thilinasGit/ESP01S_Light/3D view.png

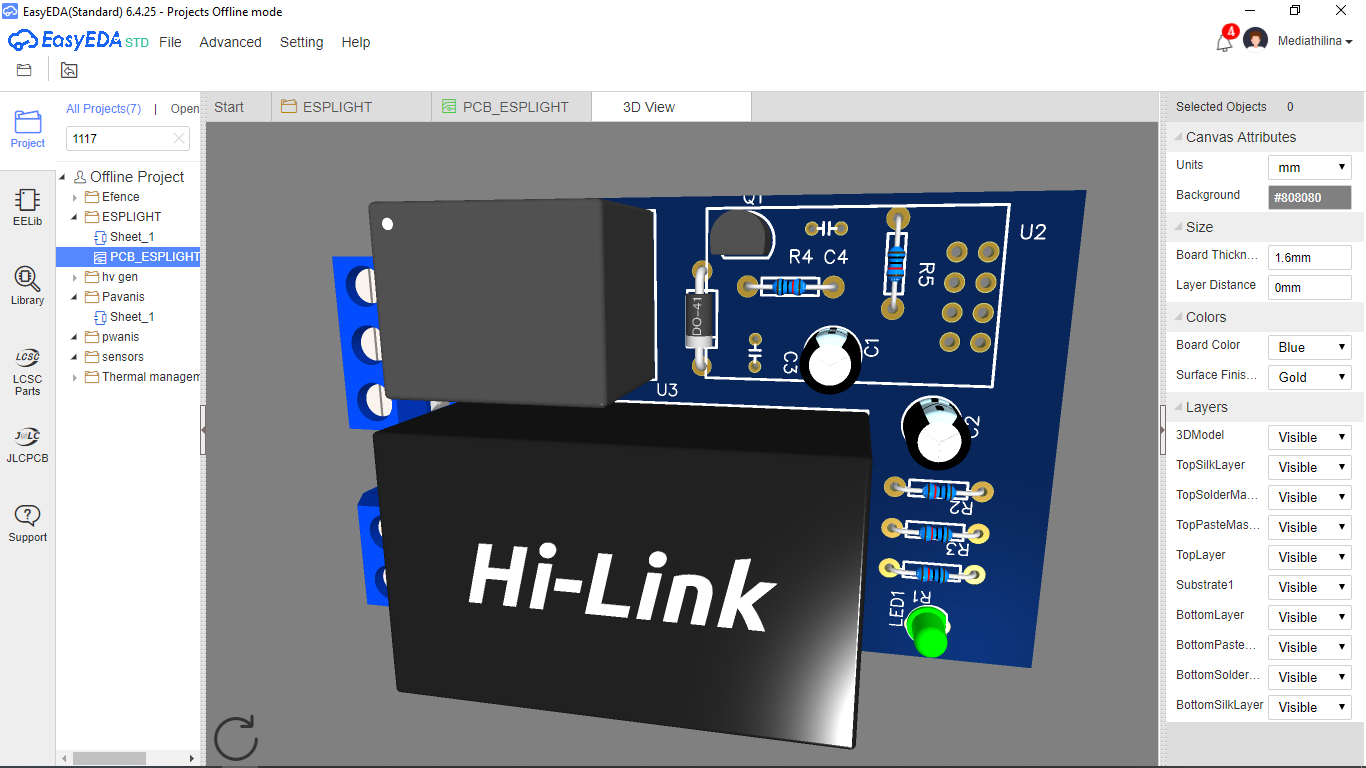
3D view.png
