thilinasGit/ESP01S_Light/backview.png

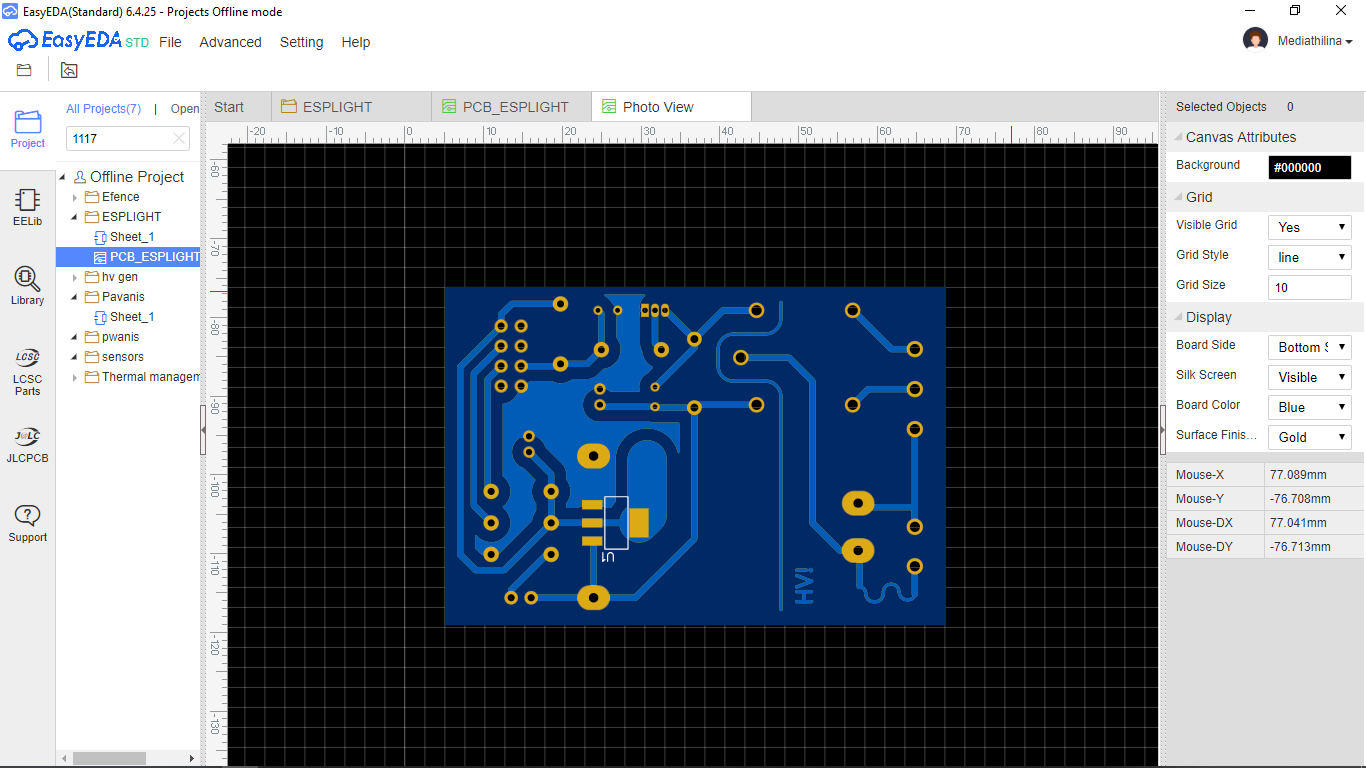
backview.png
