thilinasGit/ESP01S_Light/Schematic.png

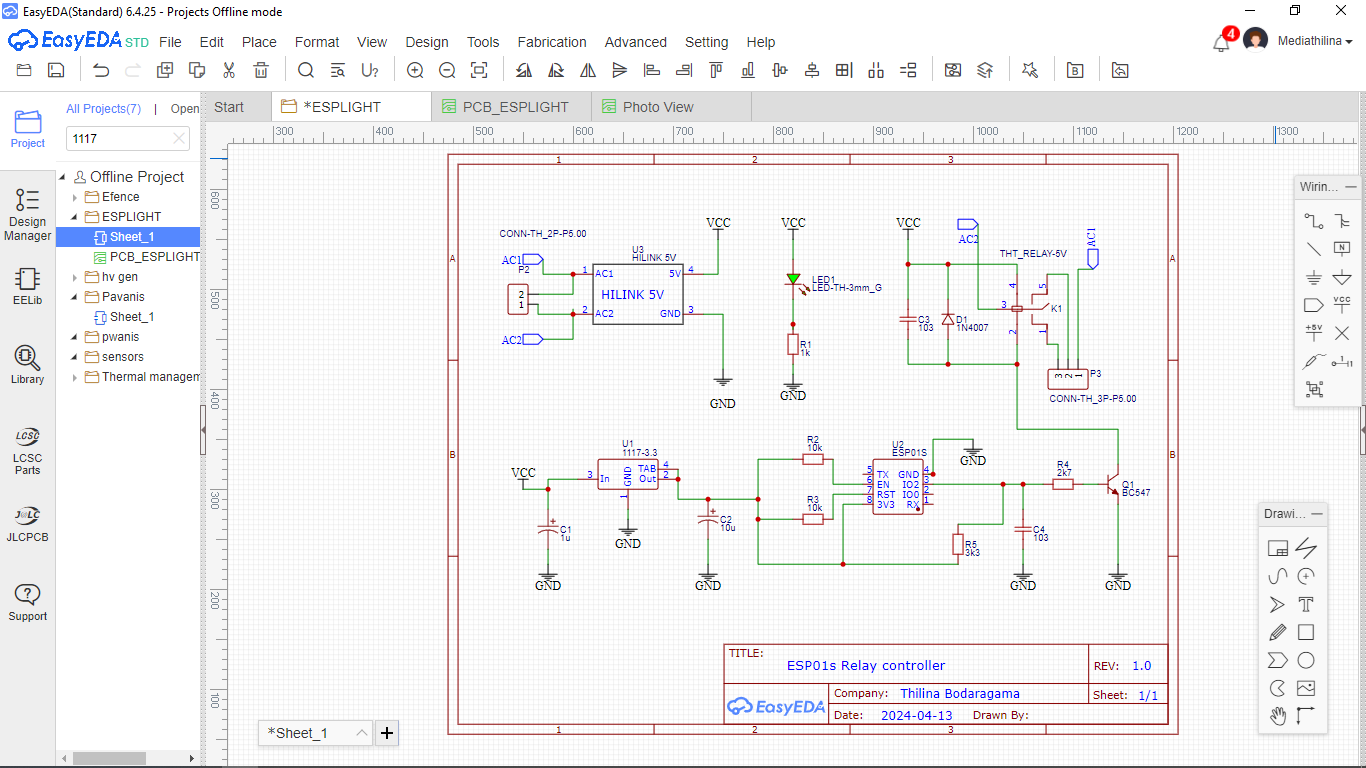
Schematic.png
