thilinasGit/ESP01S_Light/Screenshot (164).png

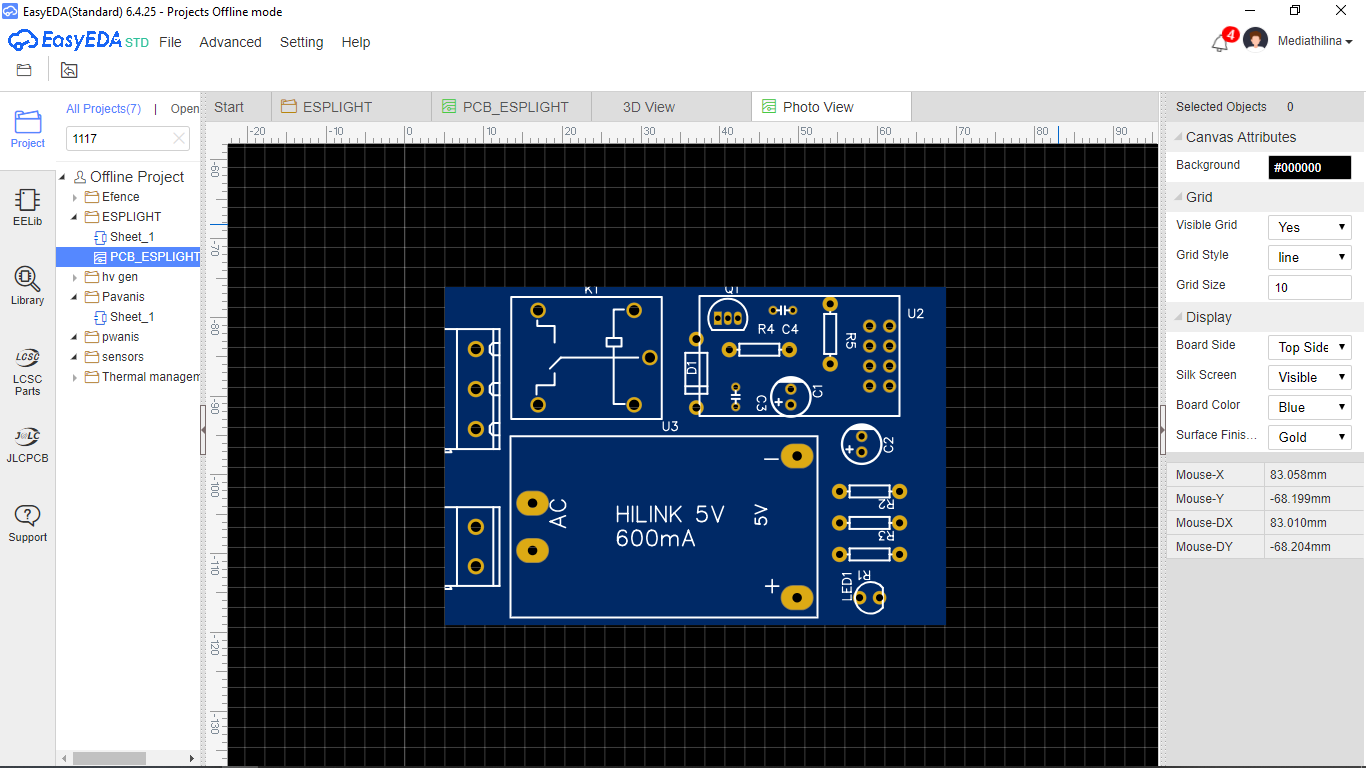
Screenshot (164).png
