thilinasGit/ESP01S_Light/BOM_ESPLIGHT.csv

ID | Name | Designator | Footprint | Quantity
1 | 1u | C1 | CAP-D5.0×F2.0 | 1
2 | 10u | C2 | CAP-D5.0×F2.0 | 1
3 | 103 | C3,C4 | 2.5MM CERAMIC CAP | 2
4 | 1N4007 | D1 | DO-41_BD2.4-L4.7-P8.70-D0.9-RD | 1
5 | THT_RELAY-5V | K1 | RELAY-TH_RELAY-SPST | 1
6 | LED-TH-3mm_G | LED1 | LED-TH_BD3.0_GREEN | 1
7 | CONN-TH_2P-P5.00 | P2 | CONN-TH_2P-P5.00 | 1
8 | CONN-TH_3P-P5.00 | P3 | CONN-TH_3P-P5.00 | 1
9 | BC547 | Q1 | TO-92-3_L5.1-W4.1-P1.27-L | 1
10 | 1k | R1 | R_AXIAL-0.3 | 1
11 | 10k | R2,R3 | R_AXIAL-0.3 | 2
12 | 2k7 | R4 | R_AXIAL-0.3 | 1
13 | 3k3 | R5 | R_AXIAL-0.3 | 1
14 | 1117-3.3 | U1 | SOT-223-3_L6.4-W3.5-P2.30-LS7.0-BR | 1
15 | ESP01S | U2 | ESP01S-FOOT | 1
16 | HILINK 5V | U3 | HILINK_5V | 1
