thilinasGit/ESP01S_Light/PCB_ESPLIGHT.pdf

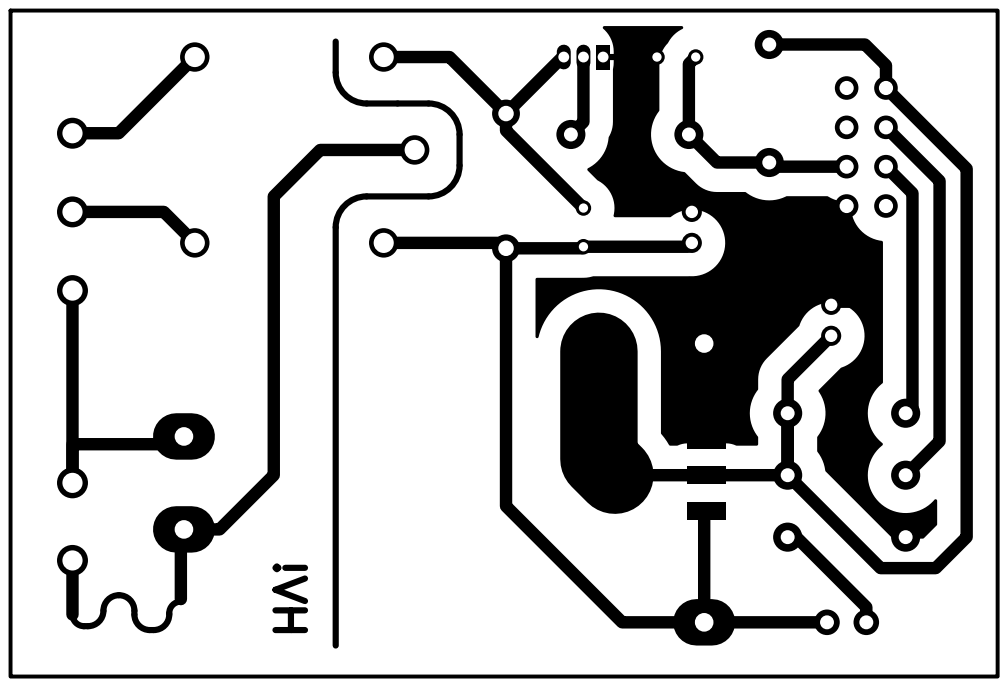
[picture p5: page 1]
