thilinasGit/ESP01S_Light/(list of files, drawings)

Other design files:
EasyEda_project.json
PCB_PCB_ESPLIGHT_C2024-04-14.json
