thilinasGit/ESP01S_Light/(commit log)

2024-04-14 Create pcb files
2024-04-14 PCB files
    [PCB_PCB_ESPLIGHT_C2024-04-14.json]
2024-04-14 Rename Screenshot (157).png to Schematic.png
2024-04-14 Rename Screenshot (160).png to Schematic.png
2024-04-14 Update and rename PCB_PCB_ESPLIGHT_C2024-04-14.json to EasyEda_project.json
    [EasyEda_project.json]
2024-04-14 3D view of the board withot esp01s
2024-04-14 3D view of the board without esp01s
